CityofHenderson/Creeklytics-Stormwater-Station/hardware/3d-printed-files/step/Battery Stand.step

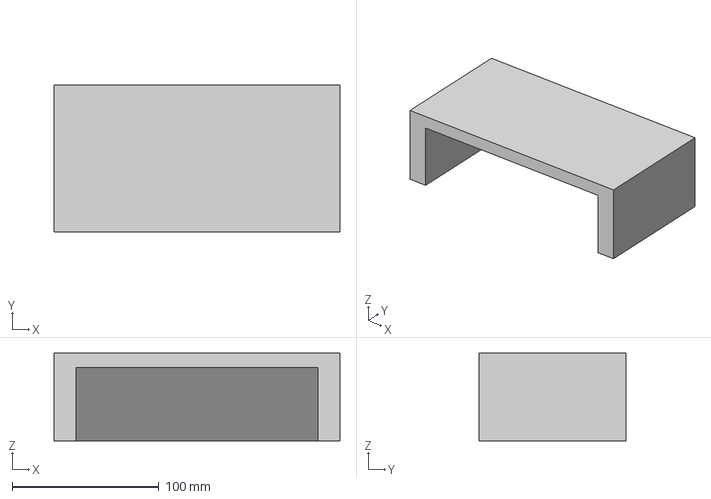
[picture p3: CAD file, 2026-11-12]
hardware/3d-printed-files/step/Battery Stand.step
195.0 x 100.0 x 60.0 mm
