CityofHenderson/Creeklytics-Stormwater-Station/hardware/3d-printed-files/step/Pipe Mount.step

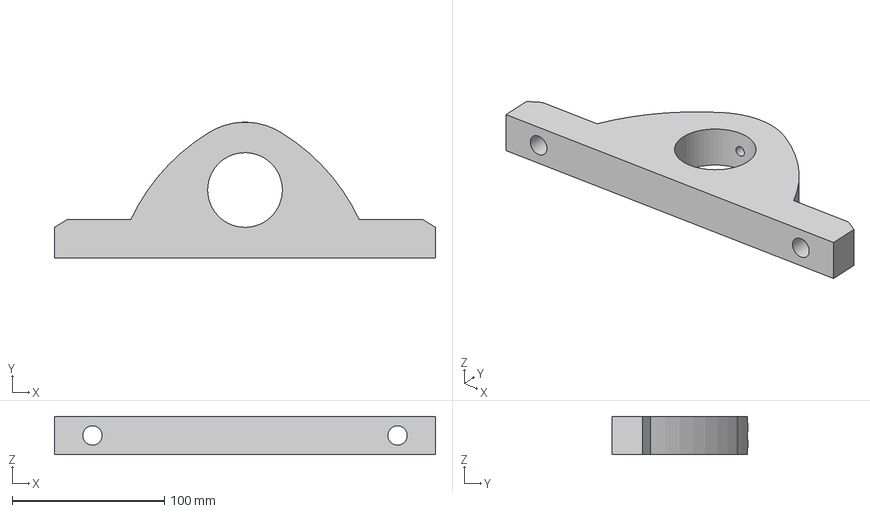
[picture p4: CAD file, 2026-11-12]
hardware/3d-printed-files/step/Pipe Mount.step
250.0 x 89.0 x 25.0 mm
