CityofHenderson/Creeklytics-Stormwater-Station/hardware/3d-printed-files/step/Probe Tube Cap.step

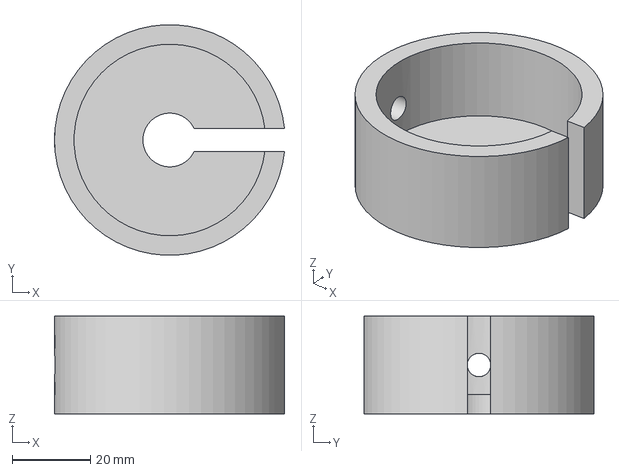
[picture p5: CAD file, 2026-11-12]
hardware/3d-printed-files/step/Probe Tube Cap.step
58.8 x 58.9 x 25.0 mm
