CityofHenderson/Creeklytics-Stormwater-Station/hardware/3d-printed-files/step/Probe Spacer.step

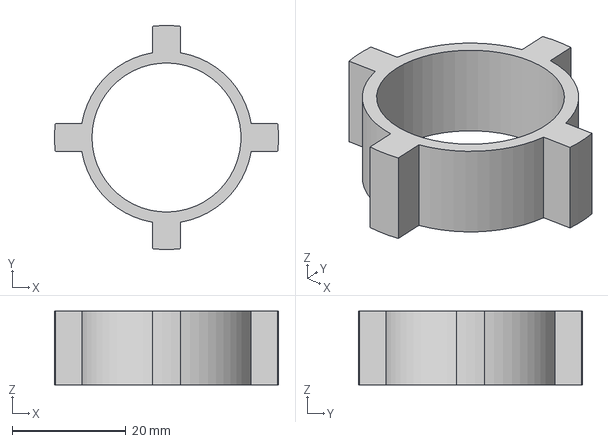
[picture p6: CAD file, 2026-11-12]
hardware/3d-printed-files/step/Probe Spacer.step
39.5 x 39.5 x 13.0 mm
