CityofHenderson/Creeklytics-Stormwater-Station/(list of files, cad)

Other CAD files:
hardware/3d-printed-files/f3d/Battery Stand.f3d
hardware/3d-printed-files/f3d/Pipe Mount.f3d
hardware/3d-printed-files/f3d/Probe Spacer.f3d
hardware/3d-printed-files/f3d/Probe Tube Cap.f3d
