CityofHenderson/Creeklytics-Stormwater-Station/hardware/wiring/Wiring Diagram.pdf

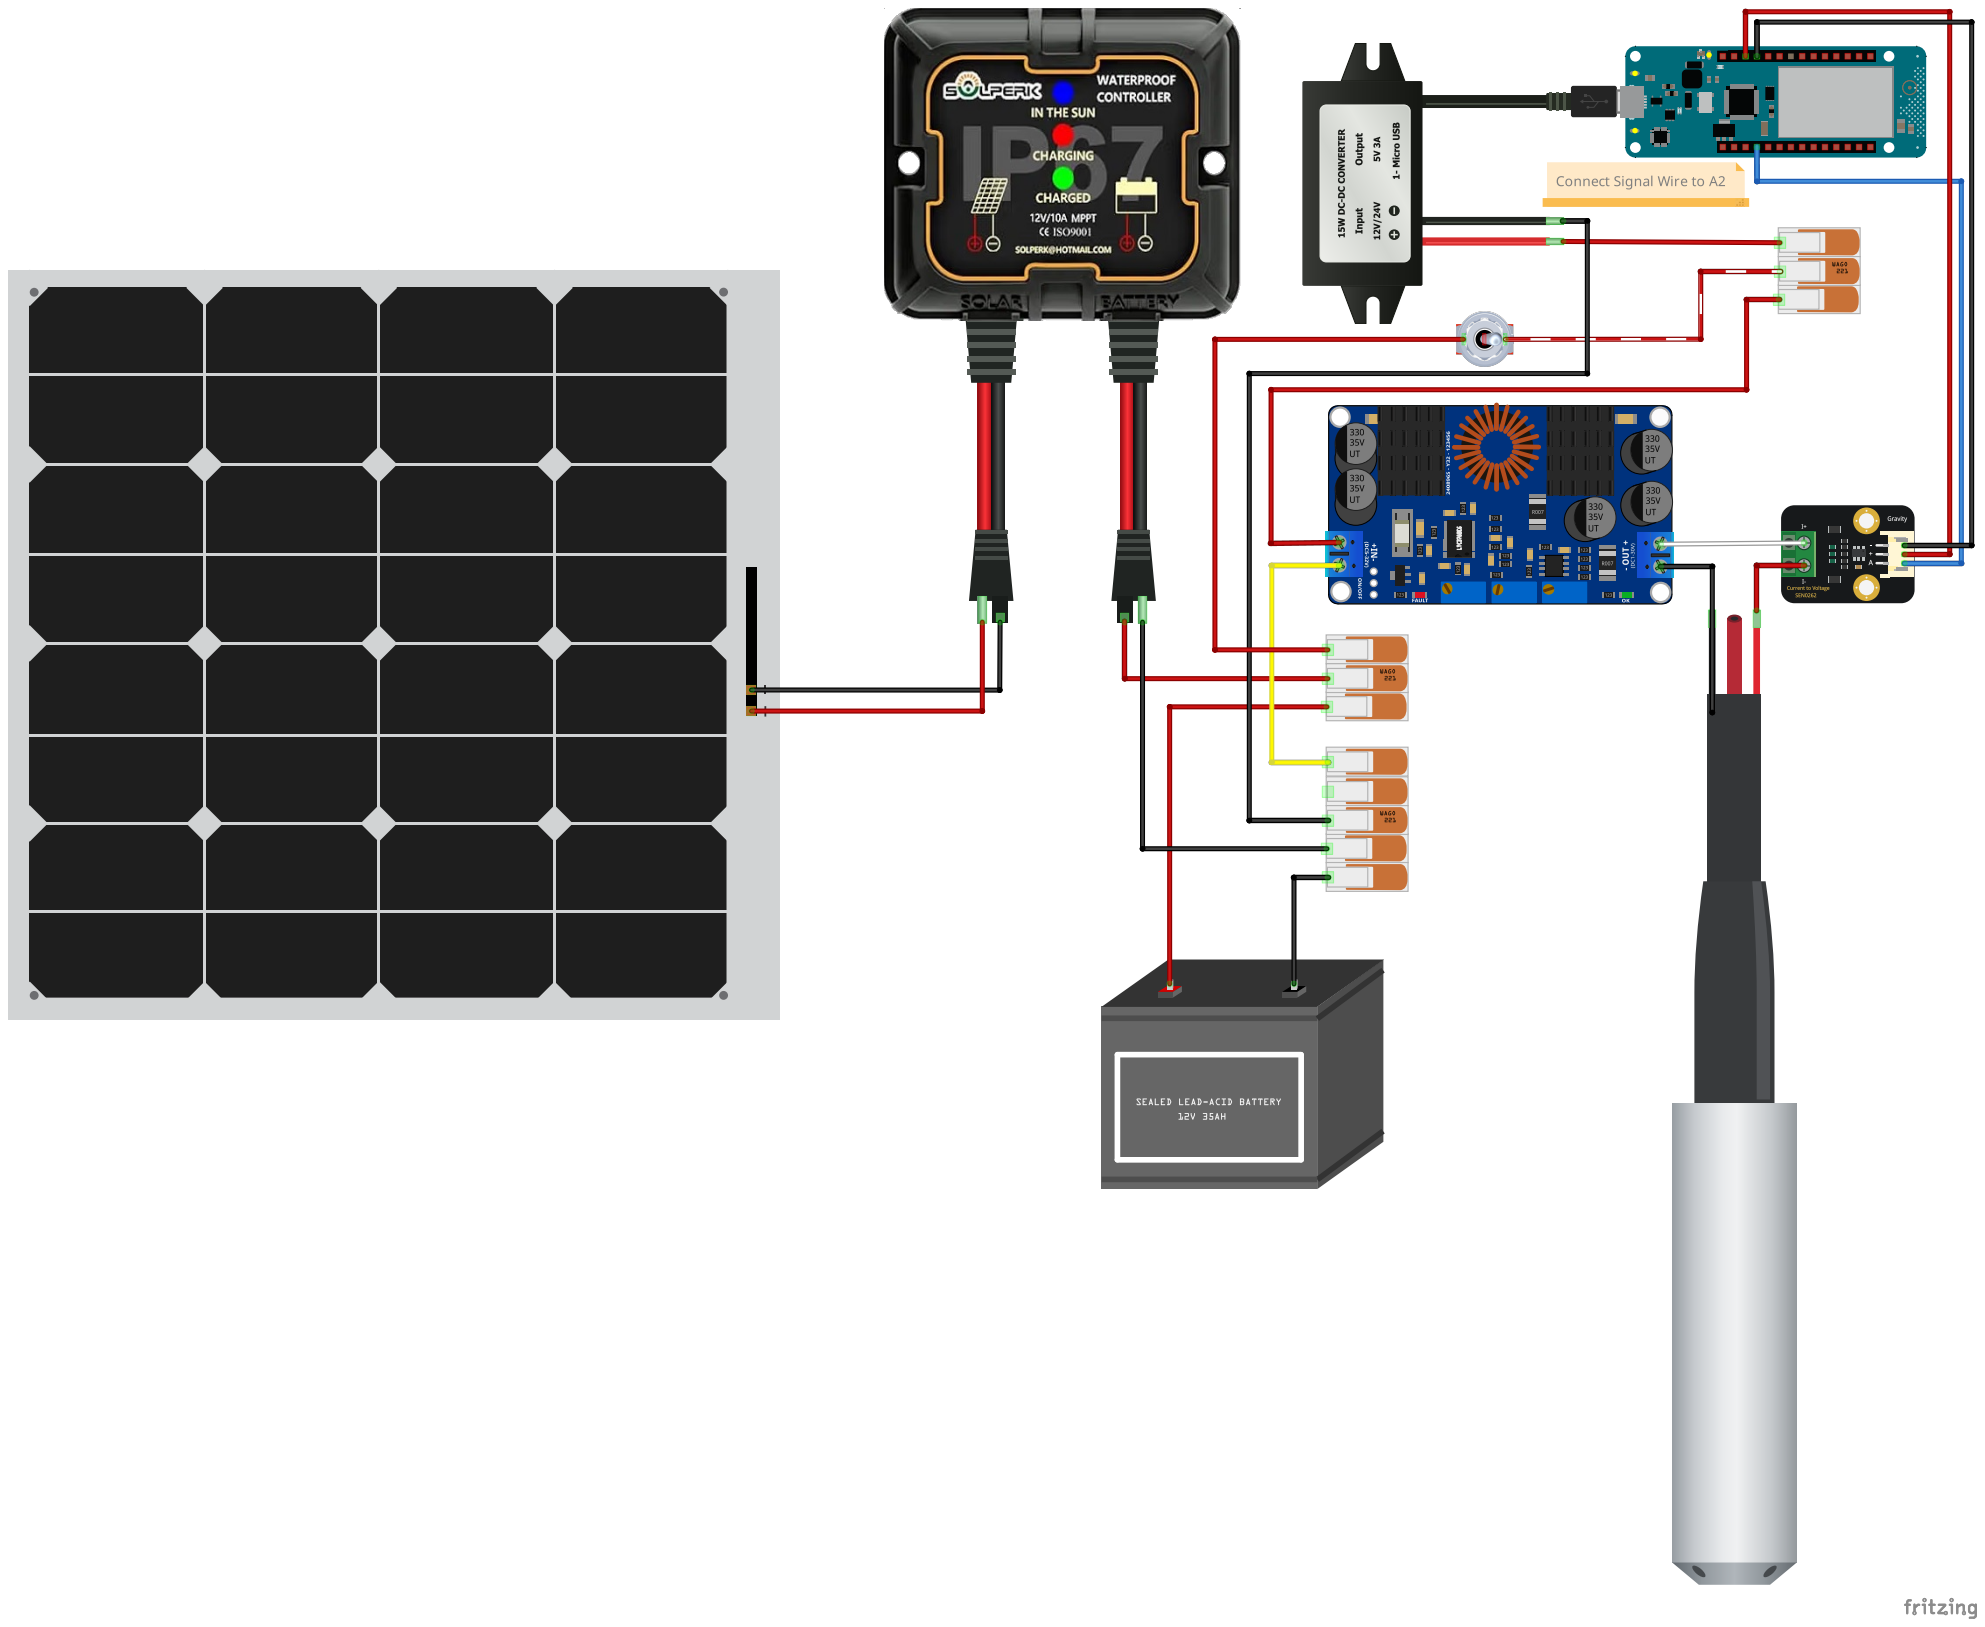
[picture p7: page 1]
