CityofHenderson/Creeklytics-Stormwater-Station/(list of files, drawings)

Other design files:
hardware/wiring/Wiring Diagram.fzz
