CityofHenderson/Creeklytics-Stormwater-Station/(notices)

Notices in the files:
README.md:
Licensing:
[Firmware License: MIT](https://opensource.org/license/MIT)
[Hardware License: CERN-OHL-S-2.0](https://spdx.github.io/license-list-data/CERN-OHL-S-2.0.html)
